FelisLynx/electronics_training_GSM_alarm_HW/images/Assembled.jpg

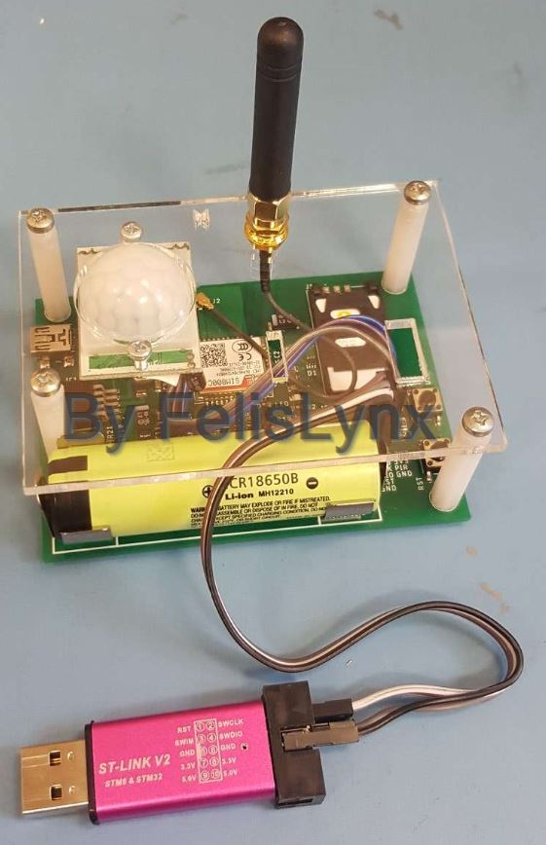
images/Assembled.jpg
