FelisLynx/electronics_training_GSM_alarm_HW/images/PIR_modification.jpg

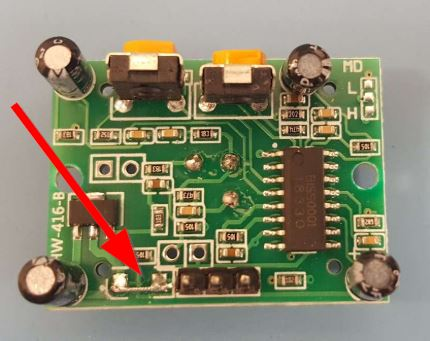
images/PIR_modification.jpg
