FelisLynx/electronics_training_GSM_alarm_HW/README.md

# electronics_training_GSM_alarm_HW
Hardware for GSM alarm (electronics training group materials)

please check wiki for more information:
https://github.com/FelisLynx/electronics_training_GSM_alarm_HW/wiki
