FelisLynx/electronics_training_GSM_alarm_HW/images/Lid_only.jpg

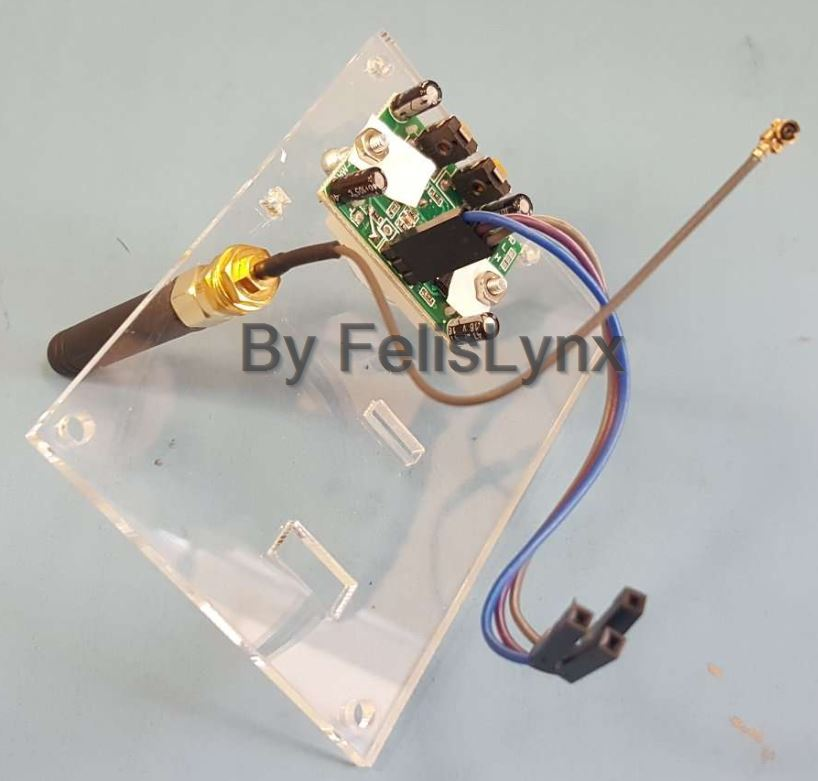
images/Lid_only.jpg
