FelisLynx/electronics_training_GSM_alarm_HW/images/PCB_no_lid.jpg

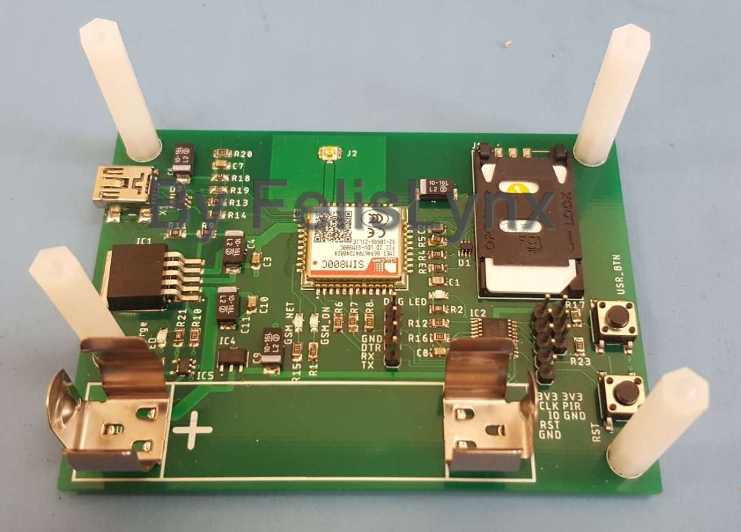
images/PCB_no_lid.jpg
