FelisLynx/electronics_training_GSM_alarm_HW/acrylic_final_no_PLS.dxf

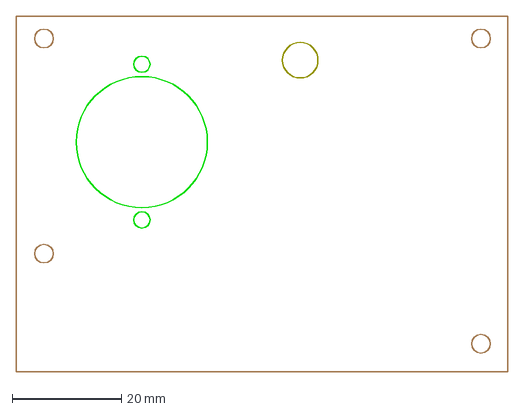
[picture p5: CAD file, 2019-07-03]
acrylic_final_no_PLS.dxf
90.0 x 65.0 mm
