FelisLynx/electronics_training_GSM_alarm_HW/schematics_main.pdf

# GND¹k

# 18650 holder = 36-54-ND x 2pcs

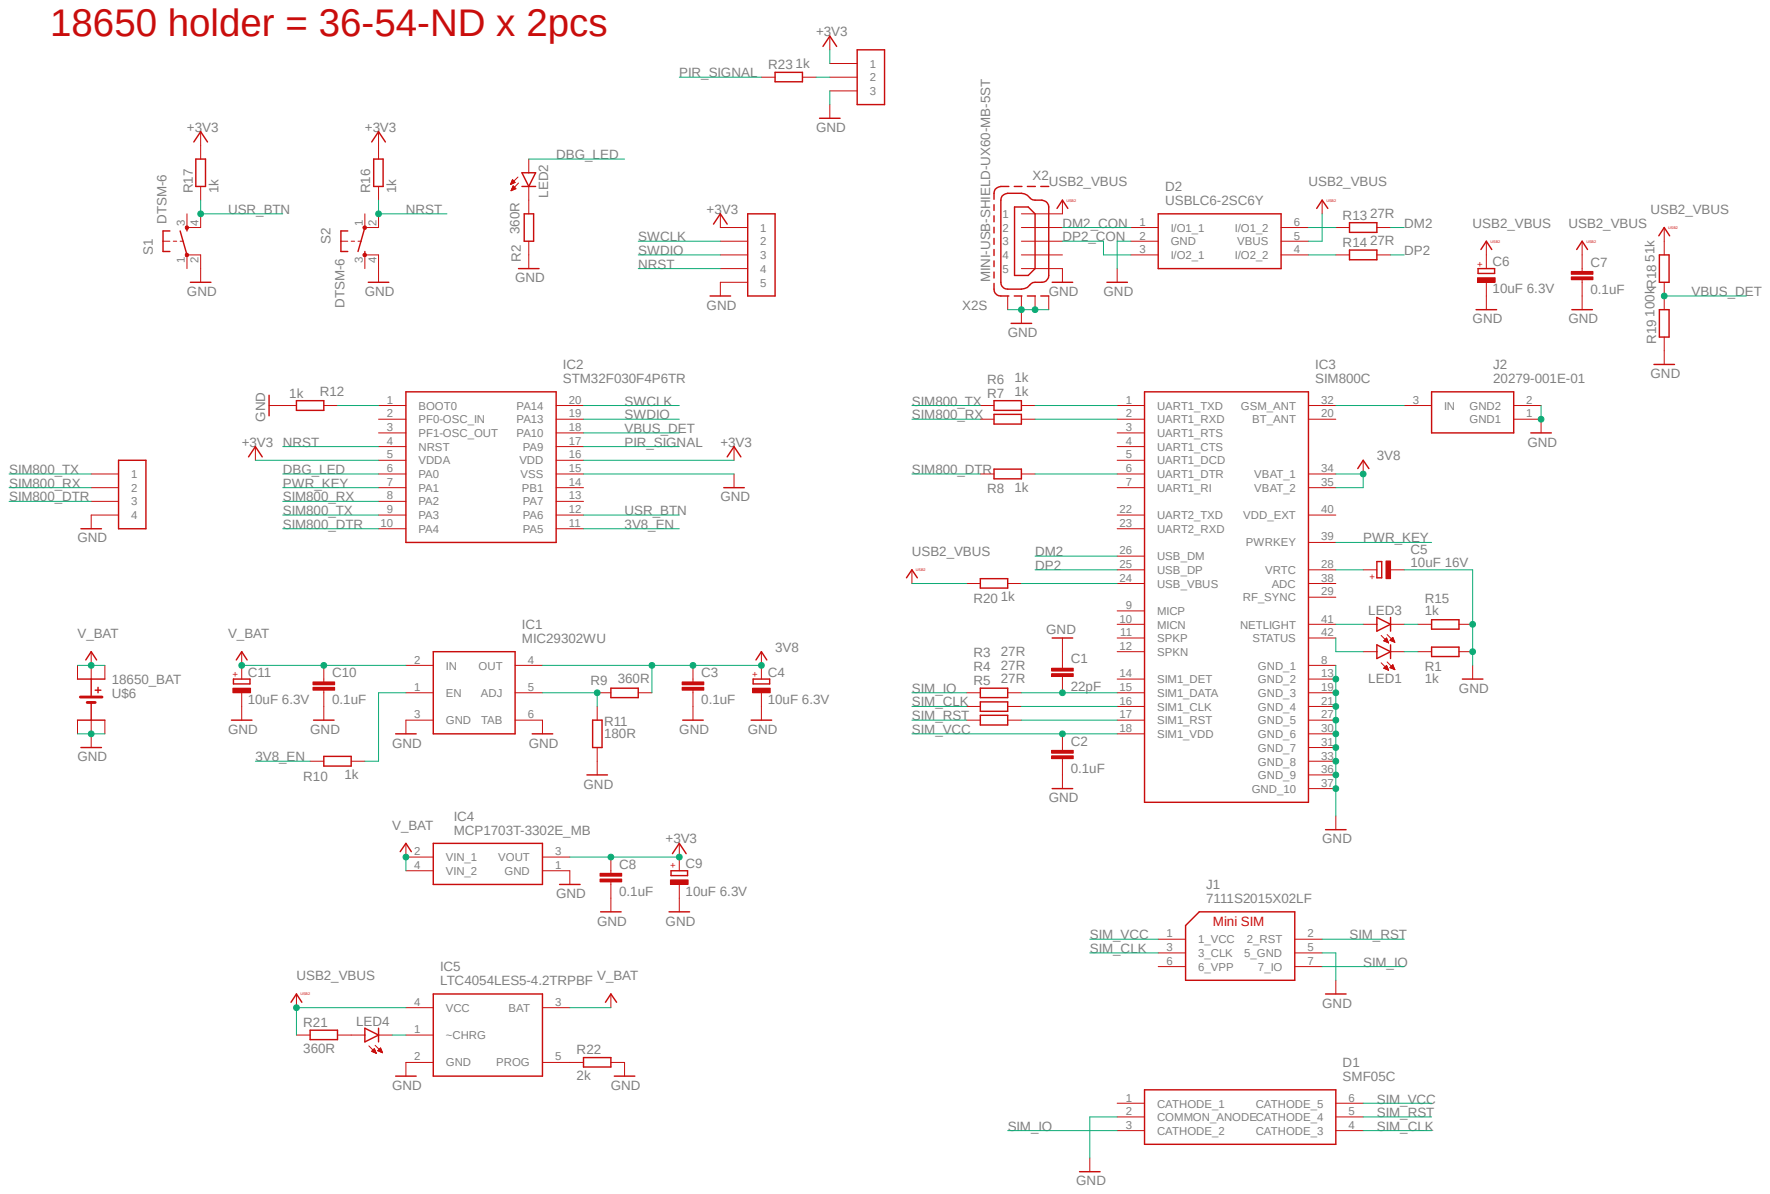
[picture p6: page 1]

MINI-USB-SHIELD-UX60-MB-5ST
