FelisLynx/electronics_training_GSM_alarm_HW/main.brd

## EAGLE design main.brd (2019-07-03)

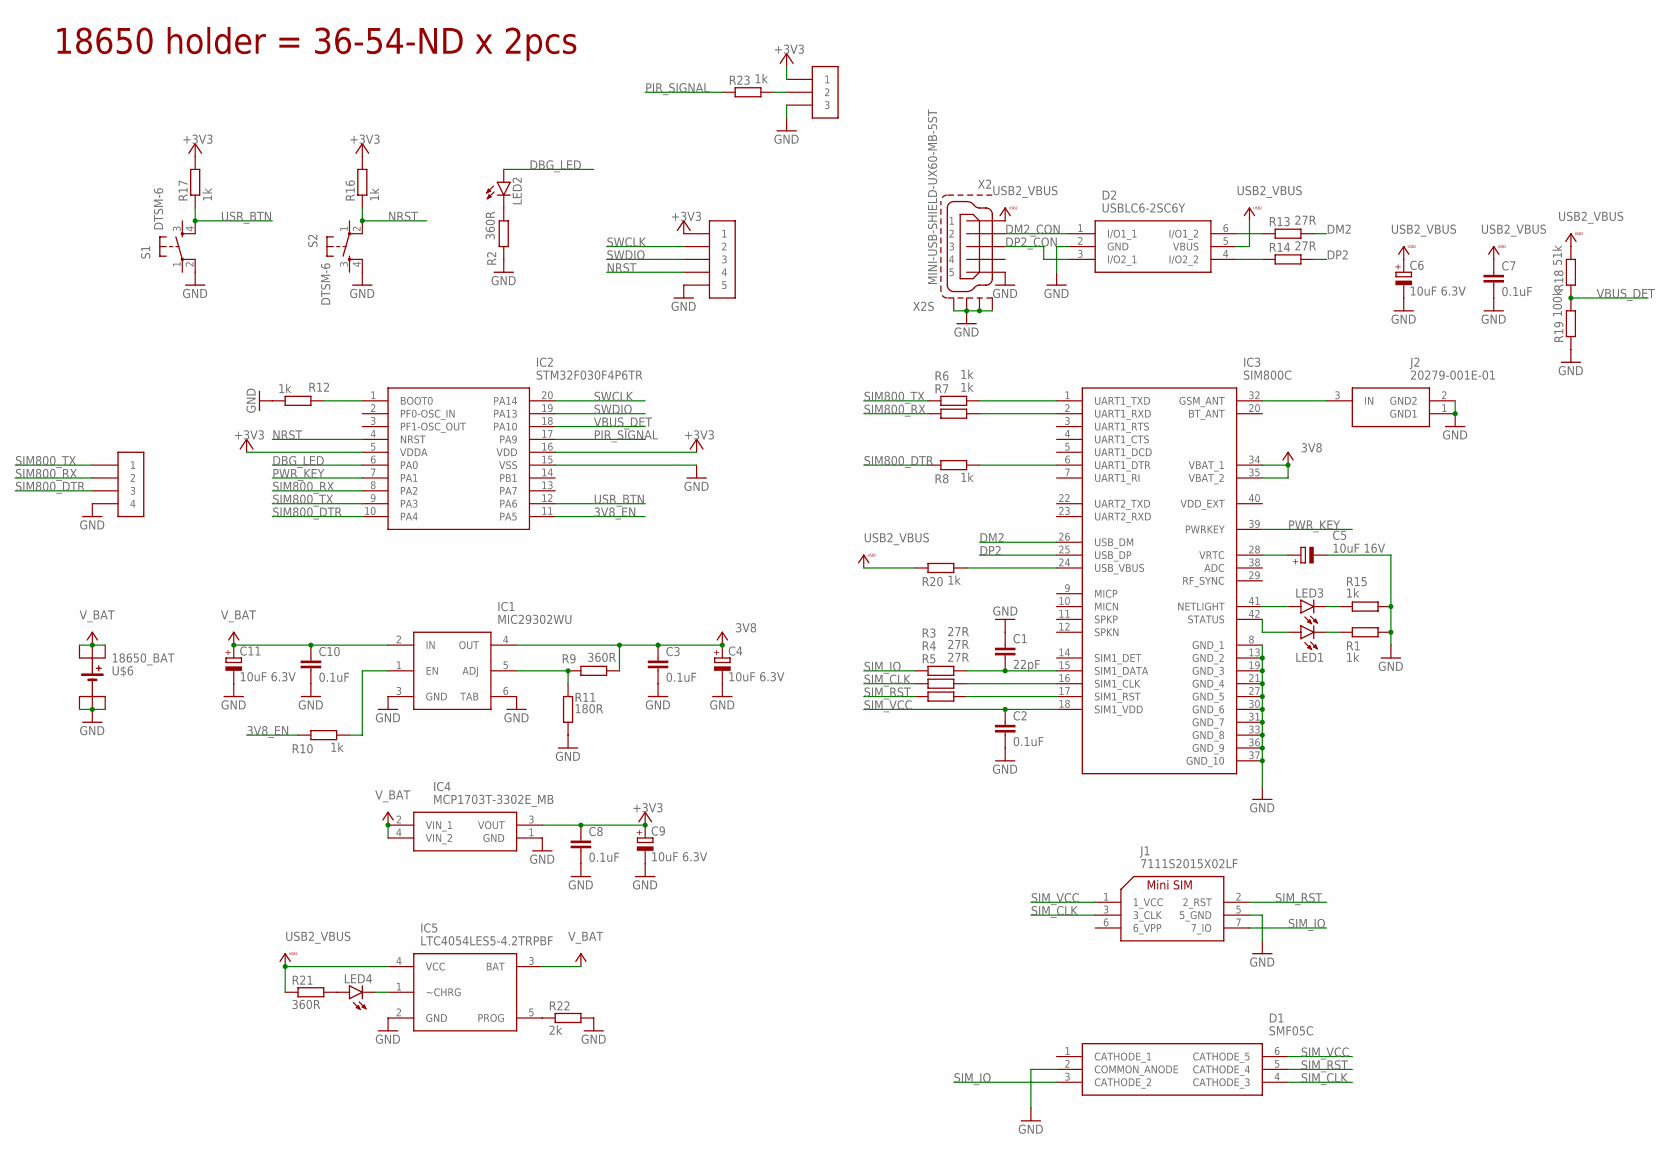
[picture p7: schematic main.sch]

Parts:
C1: 22pF; C0805
C2, C3, C7, C8, C10: 0.1uF; C0805
C4, C6, C9, C11: 10uF 6.3V; SMC_C
C5: 10uF 16V; SMC_C
D1: SMF05C; SOT65P210X110-6N
D2: USBLC6-2SC6Y; SOT95P280X145-6N
IC1: MIC29302WU
IC2: STM32F030F4P6TR; SOP65P640X120-20N
IC3: SIM800C
IC4: MCP1703T-3302E_MB; SOT-89(MB)
IC5: LTC4054LES5-4.2TRPBF; SOT95P280X100-5N
J1: 7111S2015X02LF
J2: 20279-001E-01
LED1, LED2, LED3, LED4: LEDCHIPLED_0805; CHIPLED_0805
R1, R6, R7, R8, R10, R12, R15, R16, R17, R20, R23: 1k; R0805
R2, R9, R21: 360R; R0805
R3, R4, R5, R13, R14: 27R; R0805
R11: 180R; R0805
R18: 51k; R0805
R19: 100k; R0805
R22: 2k; R0805
S1, S2: DTSM-6
U$5: 1R_4P
U$6: 18650_BAT
U$12: 1R_5P
U$15: 1R_3P
X2: MINI-USB-SHIELD-UX60-MB-5ST; UX60-MB-5ST

Connections:
3V8: C3.1, C4.+, IC1.4 (OUT), IC3.34 (VBAT_1), IC3.35 (VBAT_2), R9.2
3V8_EN: IC2.11 (PA5), R10.1
+3V3: C8.1, C9.+, IC2.5 (VDDA), IC2.16 (VDD), IC4.3 (VOUT), R16.2, R17.2, U$12.P$1 (1), U$15.P$1 (1)
DBG_LED: IC2.6 (PA0), LED2.A
DM2: IC3.26 (USB_DM), R13.2
DM2_CON: D2.1 (I/O1_1), X2.2
DP2: IC3.25 (USB_DP), R14.2
DP2_CON: D2.3 (I/O2_1), X2.3
GND: C1.1, C2.2, C3.2, C4.-, C5.-, C6.-, C7.2, C8.2, C9.-, C10.2, C11.-, D1.2 (COMMON_ANODE), D2.2 (GND), IC1.3 (GND), IC1.6 (TAB), IC2.15 (VSS), IC3.8 (GND_1), IC3.13 (GND_2), IC3.19 (GND_3), IC3.21 (GND_4), IC3.27 (GND_5), IC3.30 (GND_6), IC3.31 (GND_7), IC3.33 (GND_8), IC3.36 (GND_9), IC3.37 (GND_10), IC4.1 (GND), IC5.2 (GND), J1.5 (5_GND), J2.1 (GND1), J2.2 (GND2), R1.2, R2.1, R11.1, R12.2, R15.2, R19.1, R22.2, S1.2, S2.4, U$5.P$4 (4), U$6.4, U$6.5, U$6.6, U$12.P$5 (5), U$15.P$3 (3), X2.5, X2.M1 (S1), X2.M2 (S2), X2.M3 (S3), X2.M4 (S4)
unnamed: IC3.41 (NETLIGHT), LED3.A
unnamed: LED3.C, R15.1
unnamed: IC3.42 (STATUS), LED1.A
unnamed: LED1.C, R1.1
unnamed: IC3.32 (GSM_ANT), J2.3 (IN)
unnamed: C5.+, IC3.28 (VRTC)
unnamed: C1.2, IC3.15 (SIM1_DATA), R3.2
unnamed: IC3.16 (SIM1_CLK), R4.2
unnamed: IC3.17 (SIM1_RST), R5.2
unnamed: IC2.1 (BOOT0), R12.1
unnamed: IC3.1 (UART1_TXD), R6.2
unnamed: IC3.2 (UART1_RXD), R7.2
unnamed: IC3.6 (UART1_DTR), R8.2
unnamed: IC1.1 (EN), R10.2
unnamed: D2.6 (I/O1_2), R13.1
unnamed: IC1.5 (ADJ), R9.1, R11.2
unnamed: LED2.C, R2.2
unnamed: IC3.24 (USB_VBUS), R20.2
unnamed: D2.4 (I/O2_2), R14.1
unnamed: LED4.A, R21.2
unnamed: IC5.1 (~CHRG), LED4.C
unnamed: IC5.5 (PROG), R22.1
unnamed: R23.2, U$15.P$2 (2)
NRST: IC2.4 (NRST), R16.1, S2.2, U$12.P$4 (4)
PIR_SIGNAL: IC2.17 (PA9), R23.1
PWR_KEY: IC2.7 (PA1), IC3.39 (PWRKEY)
SIM800_DTR: IC2.10 (PA4), R8.1, U$5.P$3 (3)
SIM800_RX: IC2.8 (PA2), R7.1, U$5.P$2 (2)
SIM800_TX: IC2.9 (PA3), R6.1, U$5.P$1 (1)
SIM_CLK: D1.4 (CATHODE_3), J1.3 (3_CLK), R4.1
SIM_IO: D1.3 (CATHODE_2), J1.7 (7_IO), R3.1
SIM_RST: D1.5 (CATHODE_4), J1.2 (2_RST), R5.1
SIM_VCC: C2.1, D1.6 (CATHODE_5), IC3.18 (SIM1_VDD), J1.1 (1_VCC)
SWCLK: IC2.20 (PA14), U$12.P$2 (2)
SWDIO: IC2.19 (PA13), U$12.P$3 (3)
USB2_VBUS: C6.+, C7.1, D2.5 (VBUS), IC5.4 (VCC), R18.2, R20.1, R21.1, X2.1
USR_BTN: IC2.12 (PA6), R17.1, S1.4
VBUS_DET: IC2.18 (PA10), R18.1, R19.2
V_BAT: C10.1, C11.+, IC1.2 (IN), IC4.2 (VIN_1), IC4.4 (VIN_2), IC5.3 (BAT), U$6.1, U$6.2, U$6.3

Notes on the sheet:
18650 holder = 36-54-ND x 2pcs

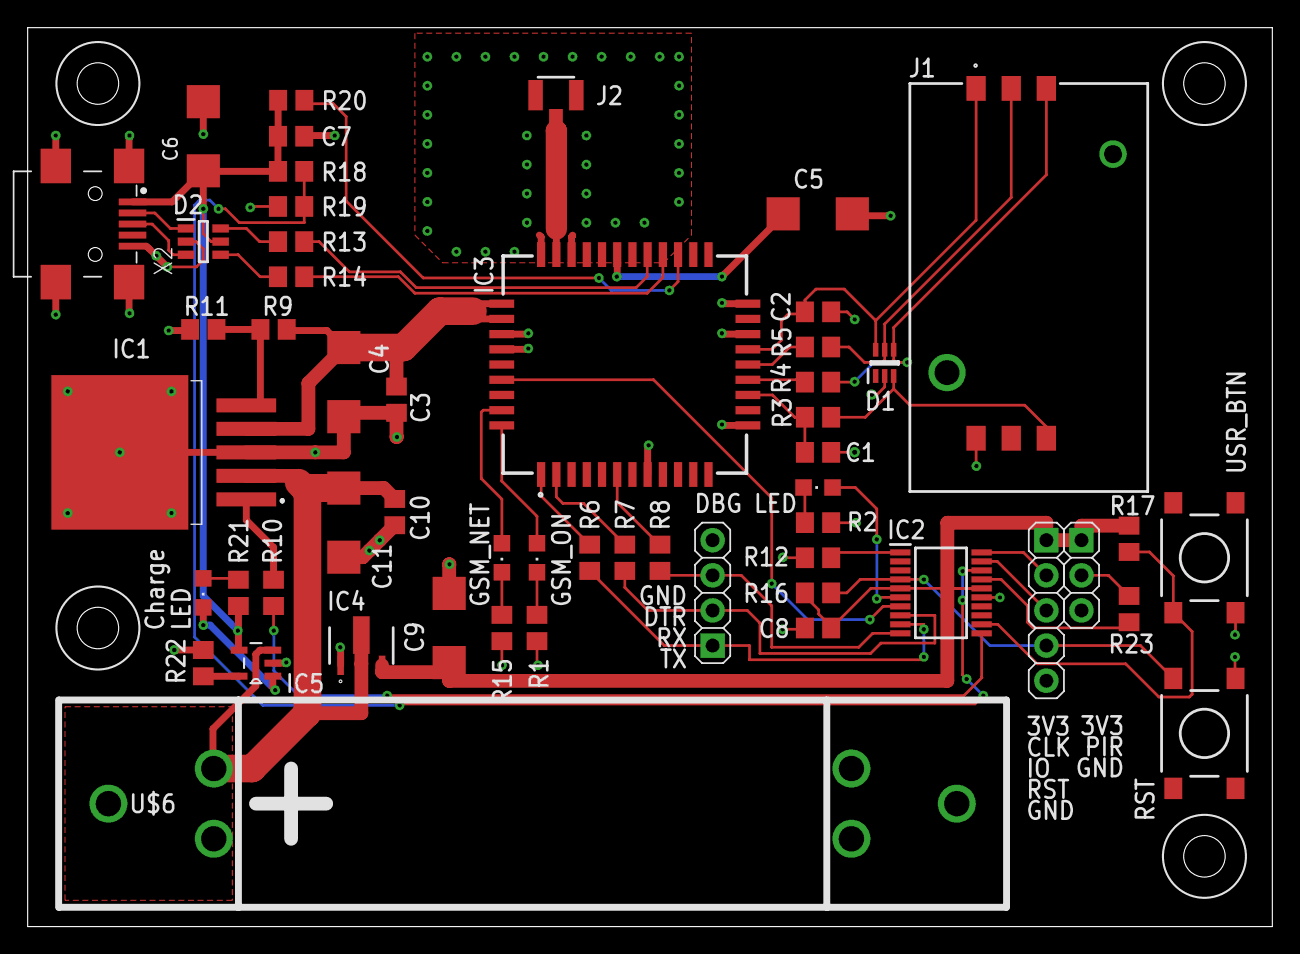
[picture p8: board main.brd from above]

Board: 2 copper layers, 90.0 x 65.0 mm, 54 parts (0 on the bottom side), 48 nets.
