FelisLynx/electronics_training_GSM_alarm_HW/Assembly_lookup.pdf

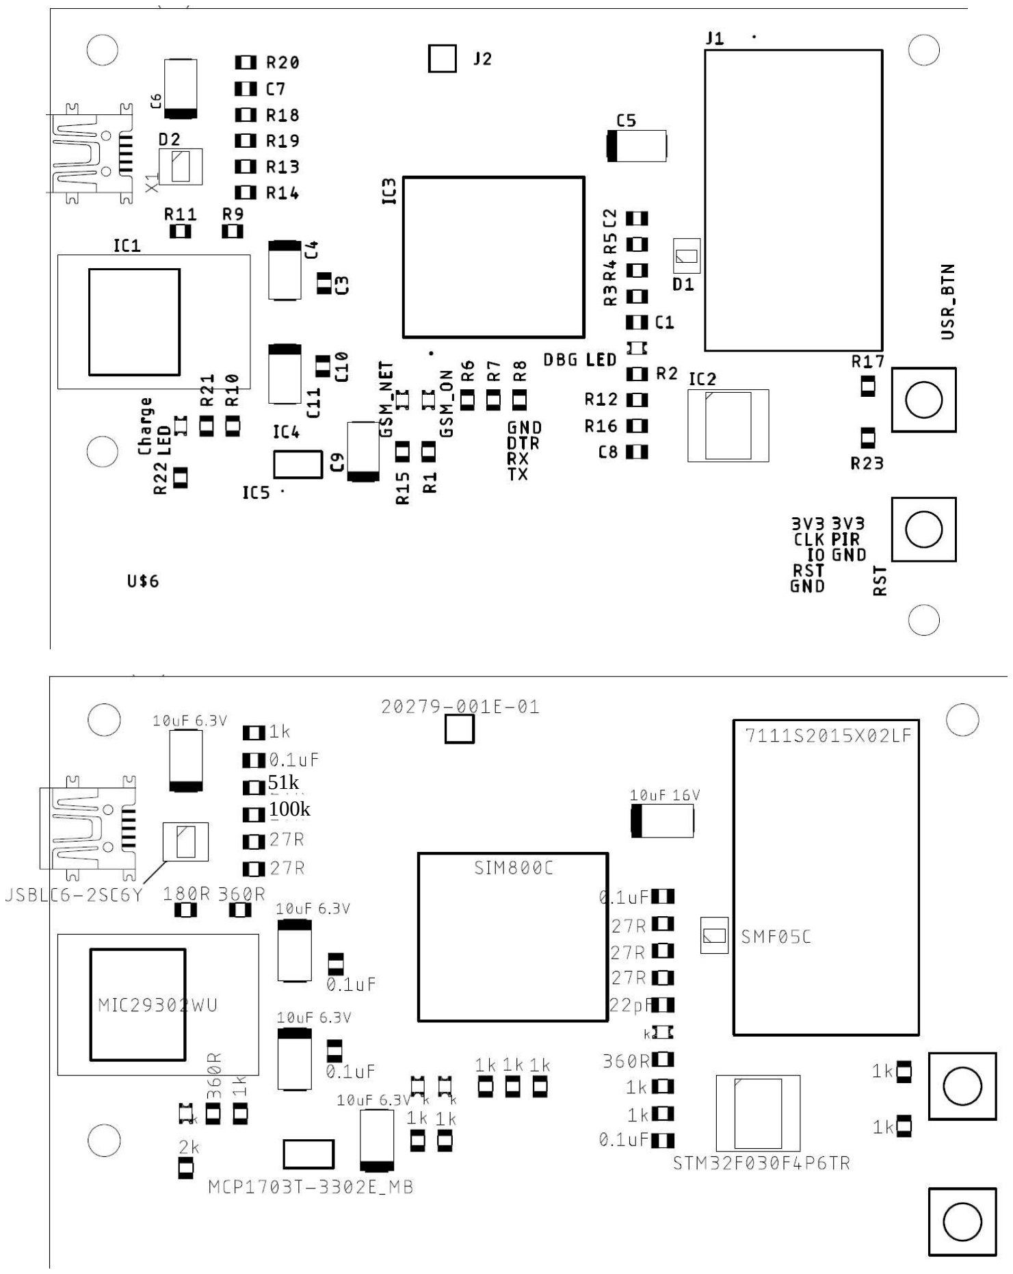
[picture p9: page 1]

51k
100k
